slogic3d-cloud/heart/hardware/drc_report.txt

** Drc report for /home/user/heart-/hardware/heart.kicad_pcb **
** Created on 2026-10-11 21:35:21 **

** Found 1 DRC violations **
[lib_footprint_mismatch]: Footprint 'USB_C_Receptacle_HRO_TYPE-C-31-M-12' does not match copy in library 'Connector_USB'.
    Local override; Severity: warning
    @(104.8028 mm, 131.1972 mm): Footprint J1

** Found 0 unconnected pads **

** Found 0 Footprint errors **

** End of Report **
