slogic3d-cloud/heart/einkauf/price.md

# Preise – LED-Herz (Euro und Dollar)

Stand: **12.10.2026 18:22** · Kurs: 1 $ = 0,8926 € · 1 € = 1,1203 $ (open.er-api.com, Mon, 12 Oct 2026 00:02:32 +0000)

Neu berechnen: `python3 tools/einkauf.py --boards 2`. **Live** = gerade vom Shop abgefragt, **Schätzung** = bitte selbst prüfen.

## Zusammenfassung

| Posten | Euro | Dollar |
|---|---|---|
| JLCPCB: 5 Platinen, davon 2 bestückt, inkl. Versand | 71,56 € | 80,16 $ |
| Selbst kaufen (BerryBase + Amazon) | 40,56 € | 45,44 $ |
| **Gesamt** | **112,12 €** | **125,60 $** |

Versandkosten bei BerryBase und Amazon sind nicht eingerechnet (hängen vom Warenkorb ab).

## Selbst kaufen

| Teil | Shop | Menge | Stück € | Stück $ | Summe € | Summe $ | Preisquelle |
|---|---|---|---|---|---|---|---|
| Seeed Studio XIAO ESP32-C3 | Amazon | 1 | 6,85 € | 7,67 $ | 6,85 € | 7,67 $ | Referenz OpenELAB, live |
| Buchsenleiste 1x40, RM 2,54, gerade | BerryBase | 1 | 0,35 € | 0,39 $ | 0,35 € | 0,39 $ | BerryBase FEMH-1X40P, live |
| Kurzhubtaster 6x6 mm, THT, H 4,3 mm | BerryBase | 2 | 0,13 € | 0,15 $ | 0,26 € | 0,29 $ | BerryBase KHT66PV43, live |
| Elko 1000 µF / 25 V, Ø10 × 20 mm, RM 5 mm | BerryBase | 1 | 0,21 € | 0,24 $ | 0,21 € | 0,24 $ | BerryBase ELK1M25VAWH, live |
| Raspberry Pi USB-C-Netzteil 5,1 V / 3 A | BerryBase | 1 | 7,90 € | 8,85 $ | 7,90 € | 8,85 $ | BerryBase RPI4NT3AW, live |
| Anycubic PLA+ Filament, Rot, 1 kg, 1,75 mm | Amazon | 1 | 18,99 € | 21,27 $ | 18,99 € | 21,27 $ | Referenz Anycubic-Shop, live |
| Blechschrauben-Sortiment (2,9 × 9,5 mm) | Amazon | 1 | 6,00 € | 6,72 $ | 6,00 € | 6,72 $ | Richtwert (Schätzung) |
| **Summe** | | | | | **40,56 €** | **45,44 $** | |

## JLCPCB

| Posten | Dollar | Euro | Quelle |
|---|---|---|---|
| 5 × Leiterplatte 2 Lagen, 162 × 153 mm | 17,01 $ | 15,18 € | JLCPCB-Angebot 12.10.2026 (inkl. Ingenieurgebühr + Dateibestätigung) |
| 100nF 50V X7R 0603 (C14663) × 94 | 1,33 $ | 1,19 € | LCSC live, 0,0142 $/Stück |
| 10uF 25V X5R 0805 (C15850) × 2 | 0,14 $ | 0,12 € | LCSC live, 0,0695 $/Stück |
| 330R 1% 0603 (C23138) × 2 | 0,01 $ | 0,00 € | LCSC live, 0,0026 $/Stück |
| 5.1k 1% 0603 (C23186) × 4 | 0,01 $ | 0,01 € | LCSC live, 0,0015 $/Stück |
| SN74AHCT1G125DBVR (C7484) × 2 | 0,20 $ | 0,18 € | LCSC live, 0,1009 $/Stück |
| SS34 Schottky 40V 3A SMA (C408258) × 2 | 0,08 $ | 0,07 € | LCSC live, 0,0402 $/Stück |
| HRO TYPE-C-31-M-12 (C165948) × 2 | 0,38 $ | 0,34 € | LCSC live, 0,1879 $/Stück |
| WS2812B-B/W 5050 RGB LED (C114586) × 92 | 7,74 $ | 6,91 € | LCSC live, 0,0841 $/Stück |
| Bestückung: Einrichtung | 8,18 $ | 7,30 € | JLCPCB-Preisliste |
| Bestückung: Schablone | 1,53 $ | 1,37 € | JLCPCB-Preisliste |
| Bestückung: 618 Lötstellen | 0,99 $ | 0,88 € | JLCPCB-Preisliste |
| Bestückung: 4 Extended-Teile | 12,28 $ | 10,96 € | JLCPCB-Preisliste |
| Bestückung: ggf. Handlöten USB-C | 3,58 $ | 3,20 € | JLCPCB-Preisliste |
| Versand nach Deutschland | 26,72 $ | 23,85 € | JLCPCB-Angebot, DHL Express (billigere Versandart wählbar) |
| **Summe JLCPCB** | **80,16 $** | **71,56 €** | |

Platinenfläche ca. 247 cm², also kein Großformat-Aufschlag (erst ab 650 cm²). Leiterplatte und Versand: echtes JLCPCB-Angebot. Bauteile und Bestückung: berechnet aus LCSC-Preisen und der JLCPCB-Preisliste – den genauen Betrag zeigt JLCPCB, sobald die Leiterplattenmontage eingeschaltet ist. Gutscheine von JLCPCB sind nicht abgezogen.

## Filament (Anycubic Kobra 2 Neo)

| Teil | Gramm |
|---|---|
| Rückschale | 89 g |
| Pixel-Gitter | 58 g |
| Diffusor | 22 g |
| Ständer | 41 g |
| Tasterstößel | 1 g |
| **Summe** | **210 g** → 1 Rolle à 1 kg reicht |
