slogic3d-cloud/heart/hardware/production/heart_bom.csv

Comment | Designator | Footprint | LCSC Part #
100nF 50V X7R 0603 | C1,C2,C3,C4,C5,C6,C7,C8,C9,C10,C11,C12,C13,C14,C15,C16,C17,C18,C19,C20,C21,C22,C23,C24,C25,C26,C27,C28,C29,C30,C31,C32,C33,C34,C35,C36,C37,C38,C39,C40,C41,C42,C43,C44,C45,C46,C48 | C_0603_1608Metric | C14663
10uF 25V X5R 0805 | C49 | C_0805_2012Metric | C15850
330R 1% 0603 | R1 | R_0603_1608Metric | C23138
5.1k 1% 0603 | R2,R3 | R_0603_1608Metric | C23186
SN74AHCT1G125DBVR | U1 | SOT-23-5 | C7484
SS34 Schottky 40V 3A SMA | D47 | D_SMA | C408258
HRO TYPE-C-31-M-12 | J1 | USB_C_Receptacle_HRO_TYPE-C-31-M-12 | C165948
WS2812B-B/W 5050 RGB LED | D1,D2,D3,D4,D5,D6,D7,D8,D9,D10,D11,D12,D13,D14,D15,D16,D17,D18,D19,D20,D21,D22,D23,D24,D25,D26,D27,D28,D29,D30,D31,D32,D33,D34,D35,D36,D37,D38,D39,D40,D41,D42,D43,D44,D45,D46 | LED_WS2812B_PLCC4_5.0x5.0mm_P3.2mm | C114586
