slogic3d-cloud/heart/hardware/chain_order.txt

# index col row  (Reihenfolge der Datenleitung)
0 4 7
1 5 6
2 4 6
3 3 6
4 2 5
5 3 5
6 4 5
7 5 5
8 6 5
9 7 4
10 6 4
11 5 4
12 4 4
13 3 4
14 2 4
15 1 4
16 0 3
17 1 3
18 2 3
19 3 3
20 4 3
21 5 3
22 6 3
23 7 3
24 8 3
25 8 2
26 7 2
27 6 2
28 5 2
29 4 2
30 3 2
31 2 2
32 1 2
33 0 2
34 0 1
35 1 1
36 2 1
37 3 1
38 5 1
39 6 1
40 7 1
41 8 1
42 7 0
43 6 0
44 2 0
45 1 0
