slogic3d-cloud/heart/cad/out/heart_case_assembly.step

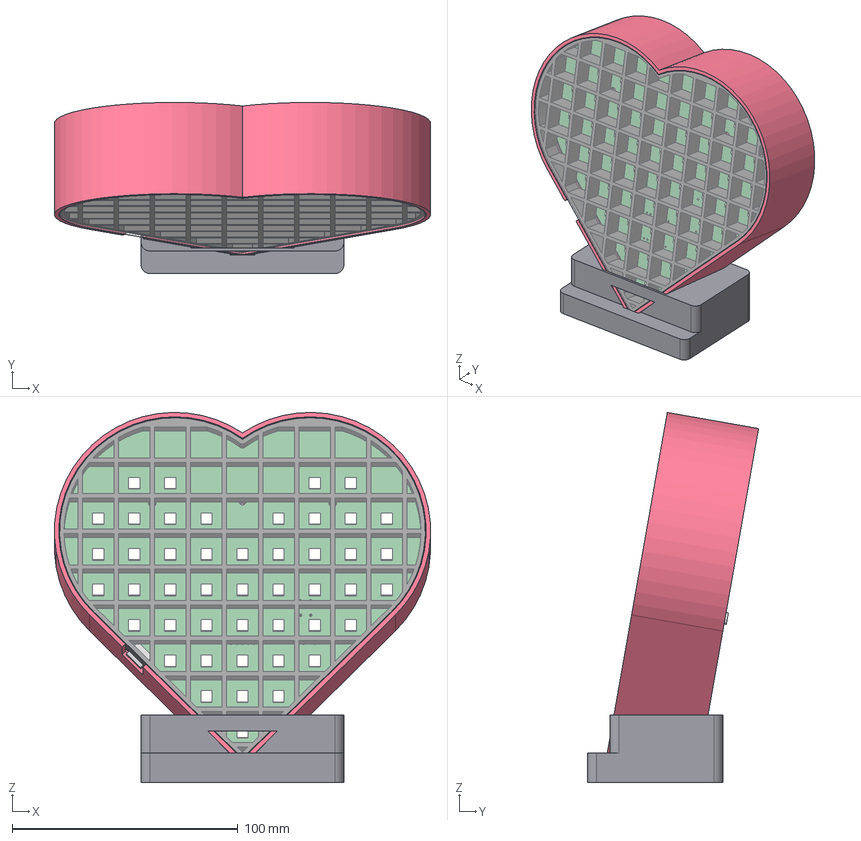
[picture p9: CAD file, 2026-10-12]
cad/out/heart_case_assembly.step
166.7 x 75.9 x 164.1 mm
heart_case_shell
heart_case_grid
heart_case_diffuser
heart_case_button_plunger
heart_stand
platzhalter_pcb
platzhalter_xiao
platzhalter_elko
platzhalter_button
platzhalter_usb
platzhalter_leds
