slogic3d-cloud/heart/cad/out/heart_case_shell.step

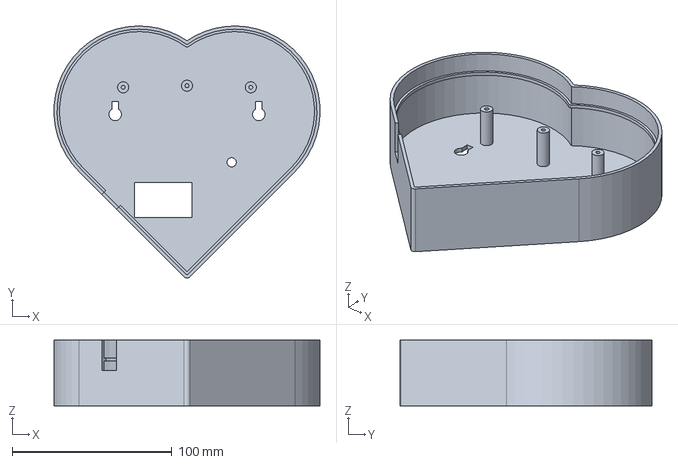
[picture p10: CAD file, 2026-10-12]
cad/out/heart_case_shell.step
166.7 x 157.9 x 41.1 mm
