slogic3d-cloud/heart/cad/out/heart_case_button_plunger.step

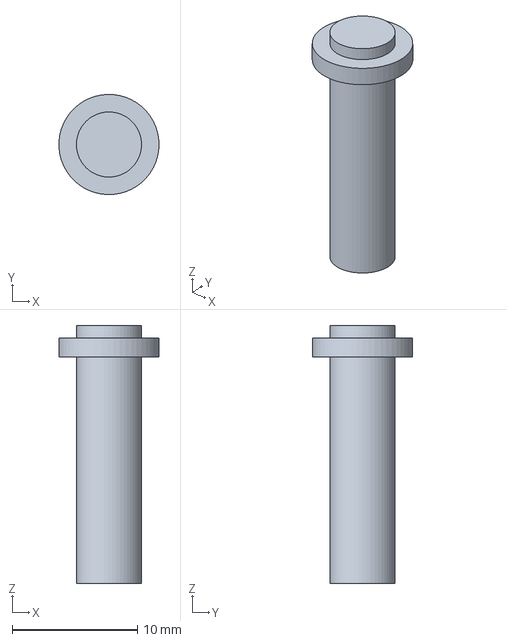
[picture p11: CAD file, 2026-10-12]
cad/out/heart_case_button_plunger.step
7.99 x 8.00 x 20.6 mm
