slogic3d-cloud/heart/cad/out/heart_case_grid.step

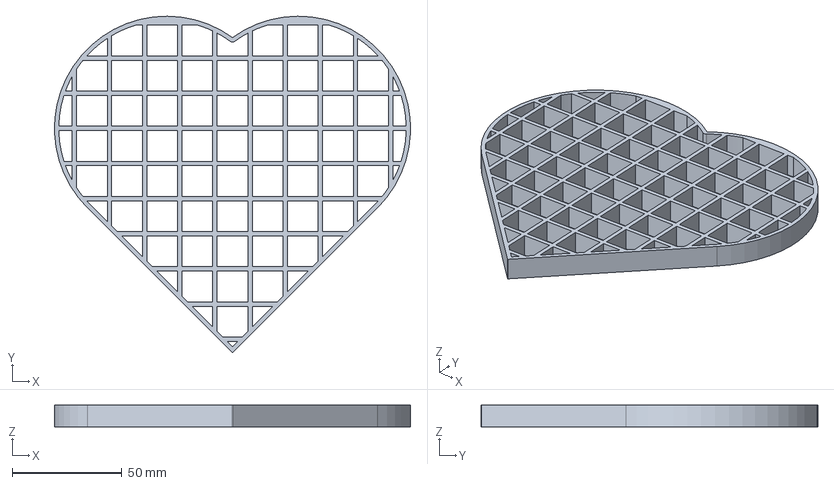
[picture p12: CAD file, 2026-10-12]
cad/out/heart_case_grid.step
162.1 x 153.3 x 10.0 mm
