slogic3d-cloud/heart/cad/out/heart_stand.step

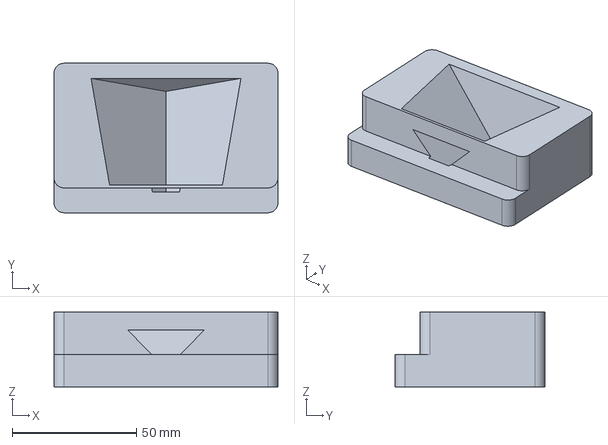
[picture p13: CAD file, 2026-10-12]
cad/out/heart_stand.step
90.0 x 60.1 x 30.0 mm
