slogic3d-cloud/heart/cad/out/heart_case_diffuser.step

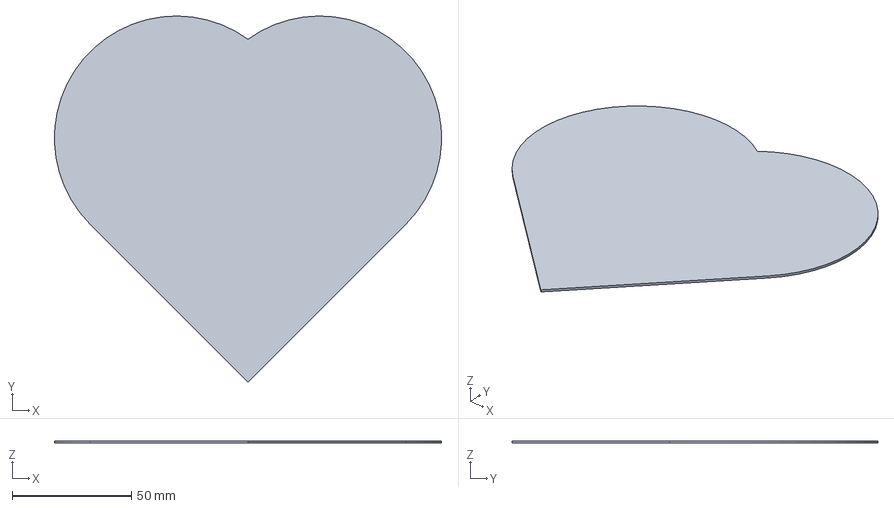
[picture p14: CAD file, 2026-10-12]
cad/out/heart_case_diffuser.step
162.1 x 153.3 x 1.00 mm
