slogic3d-cloud/heart/cad/out/heart_pcb.step

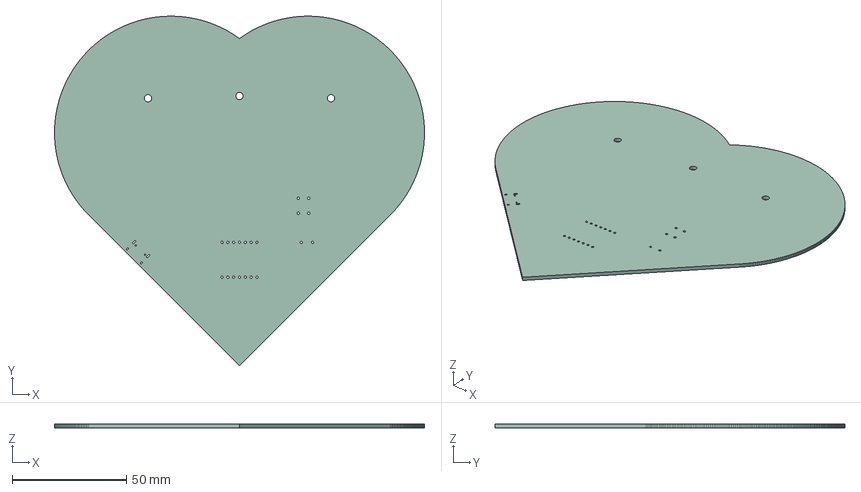
[picture p15: CAD file, 2026-10-12]
cad/out/heart_pcb.step
161.8 x 152.9 x 1.60 mm
