slogic3d-cloud/heart/(list of files, cad)

Other CAD files:
cad/out/heart_case_button_plunger.3mf
cad/out/heart_case_button_plunger.stl
cad/out/heart_case_diffuser.3mf
cad/out/heart_case_diffuser.stl
cad/out/heart_case_grid.3mf
cad/out/heart_case_grid.stl
cad/out/heart_case_shell.3mf
cad/out/heart_case_shell.stl
cad/out/heart_stand.3mf
cad/out/heart_stand.stl
