slogic3d-cloud/heart/docs/schematic.pdf

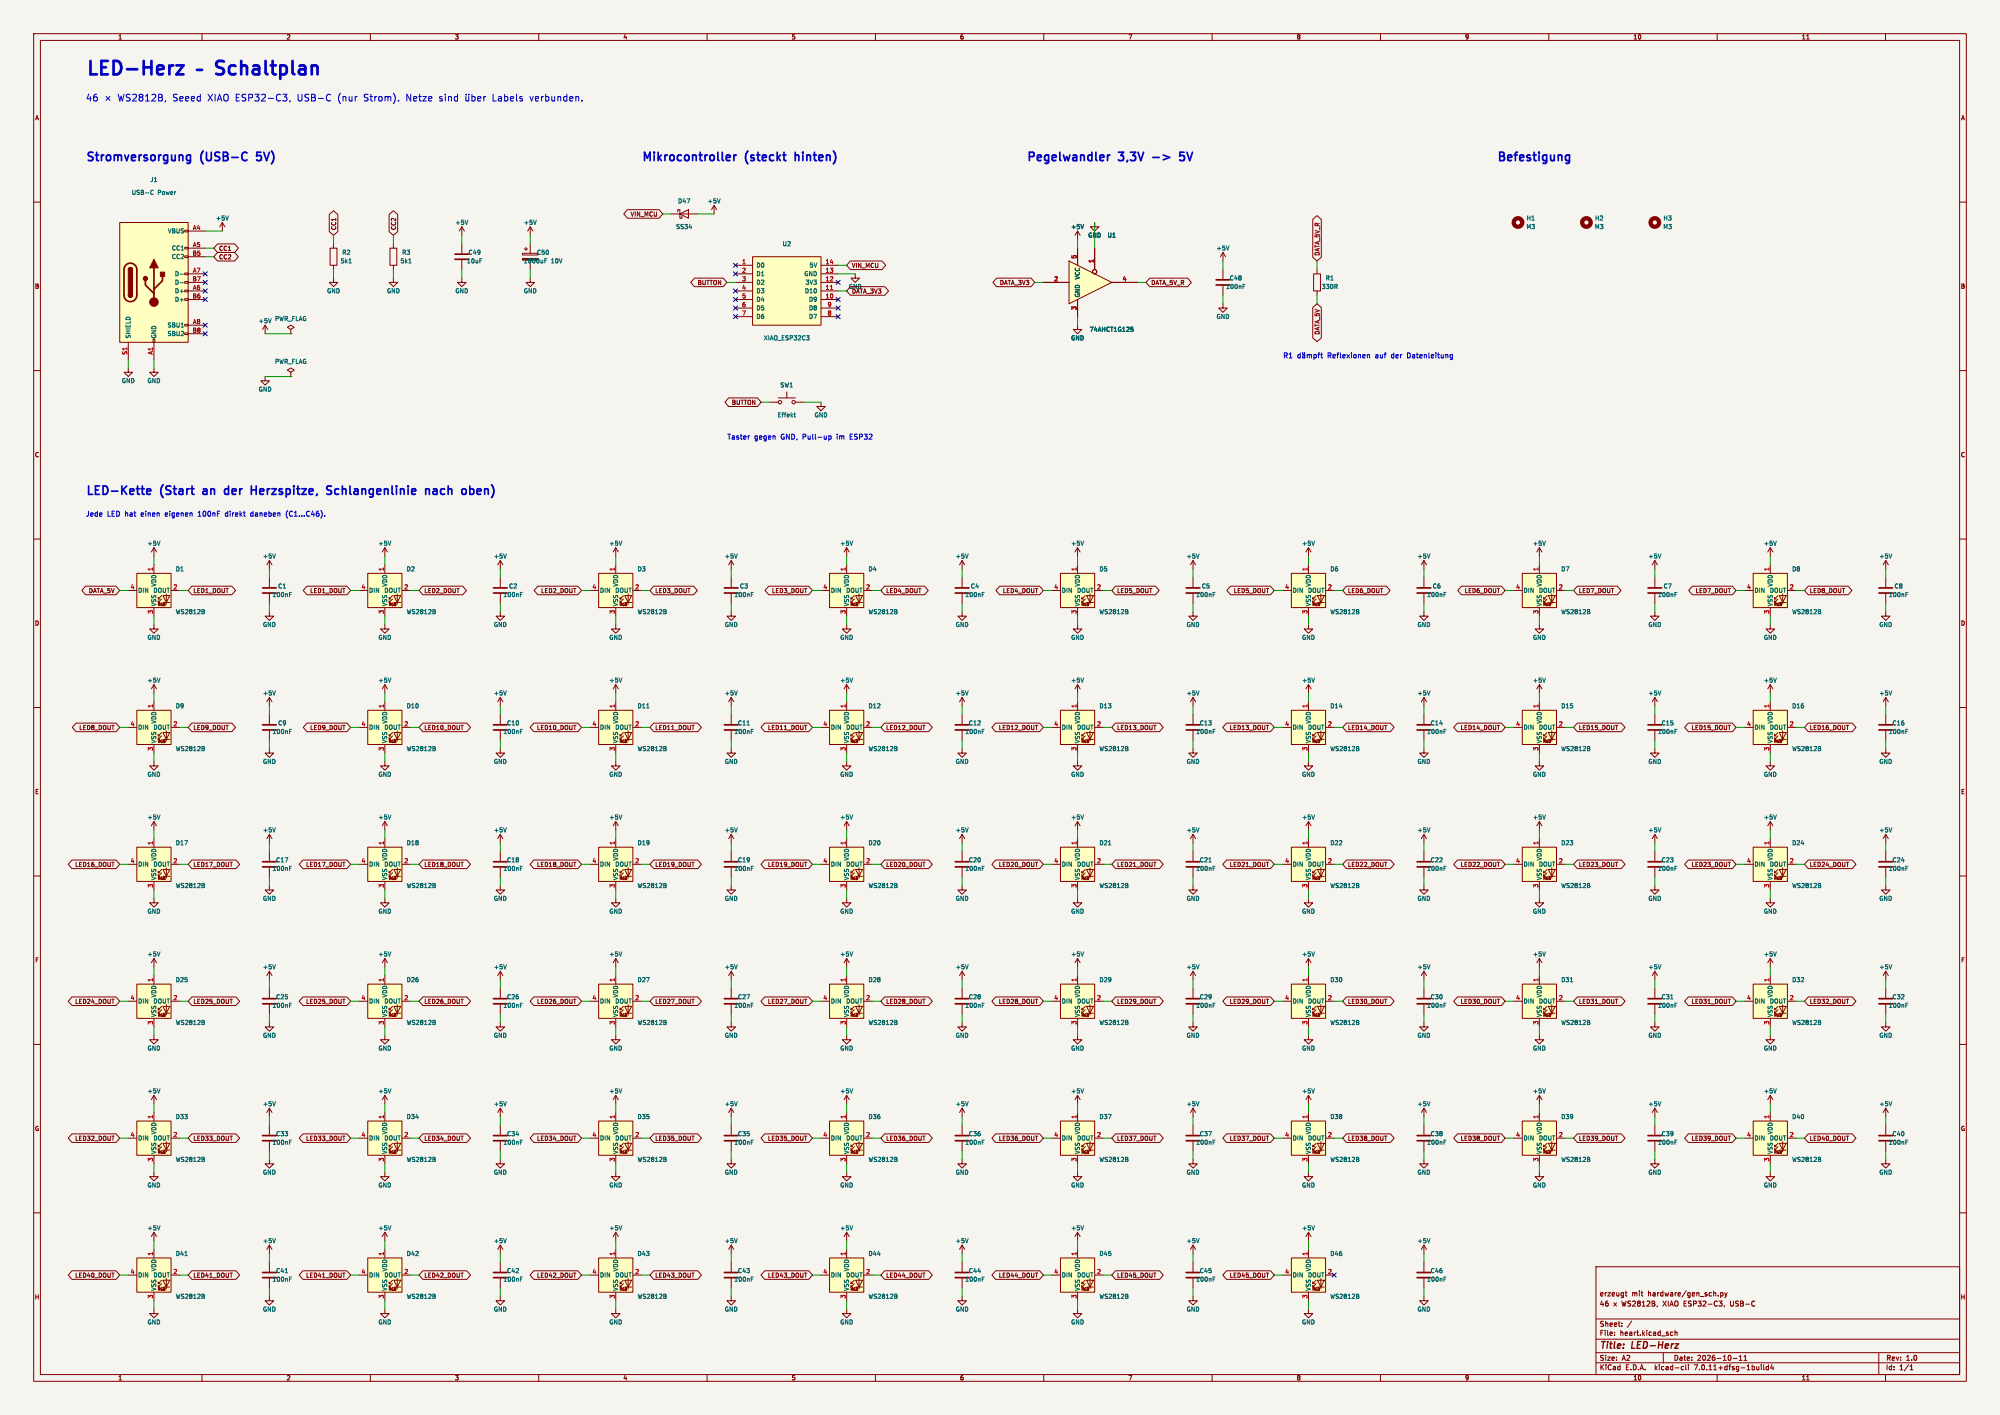
[picture p18: page 1]
