slogic3d-cloud/heart/hardware/heart.kicad_pcb

## KiCad design hardware/heart.kicad_pcb (2026-10-11)

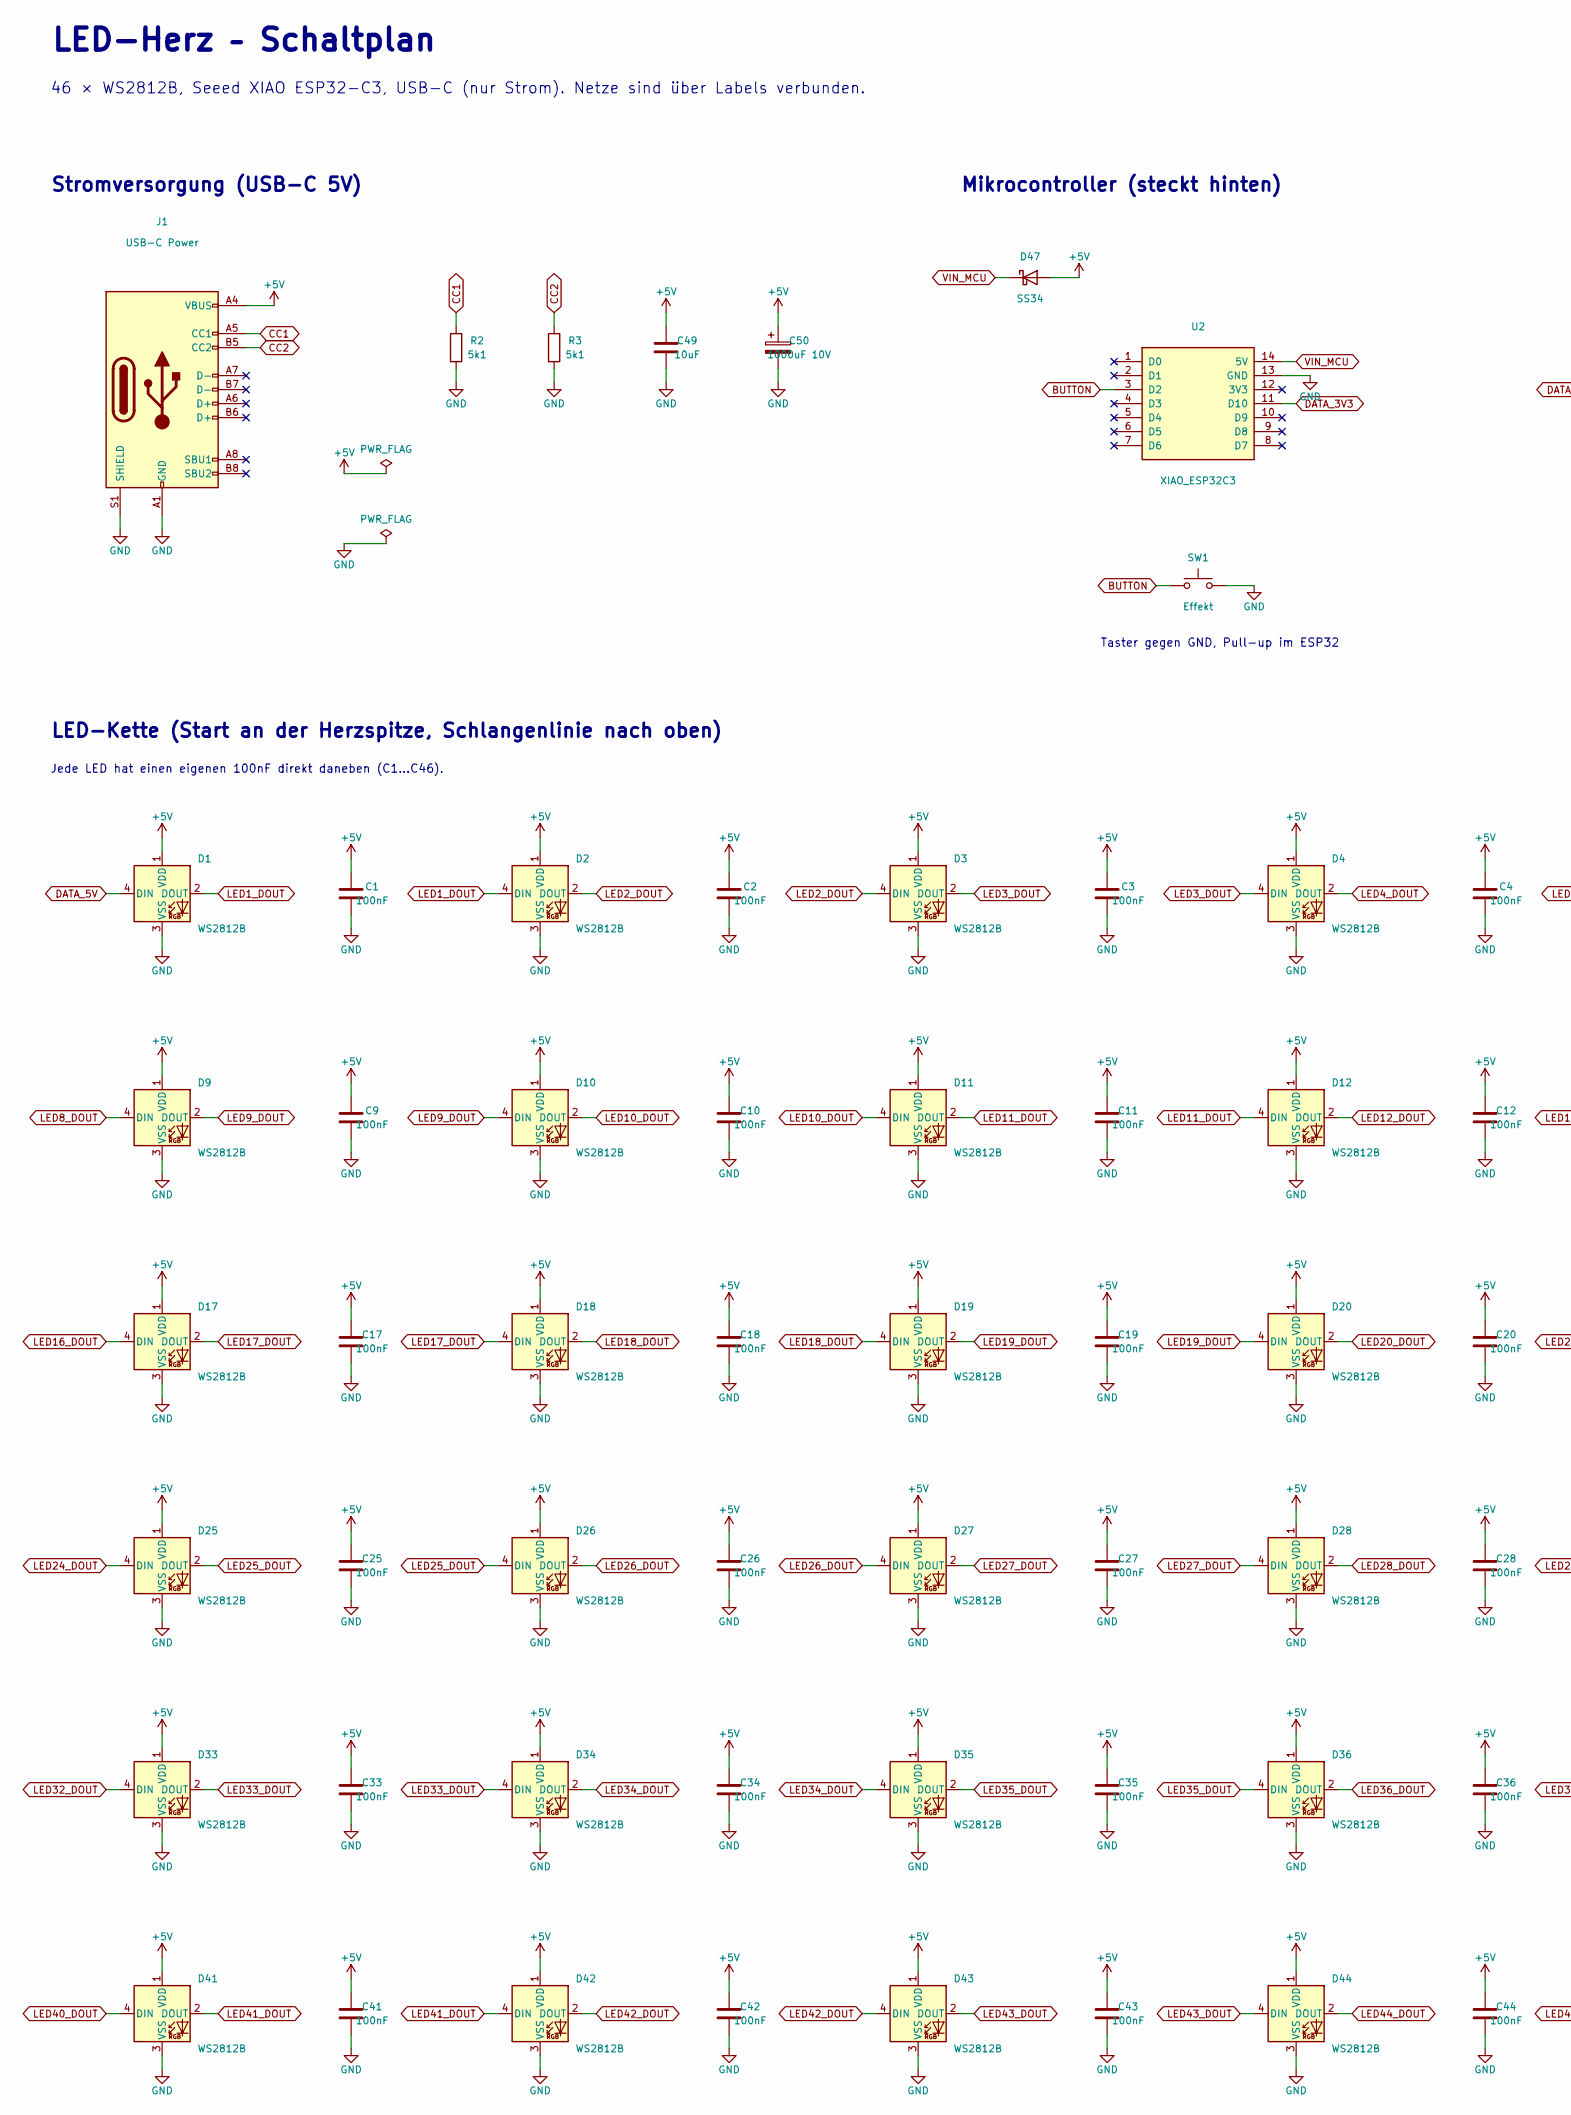
[picture p19: schematic heart.kicad_sch, LED-Herz, part in row 1, column 1]

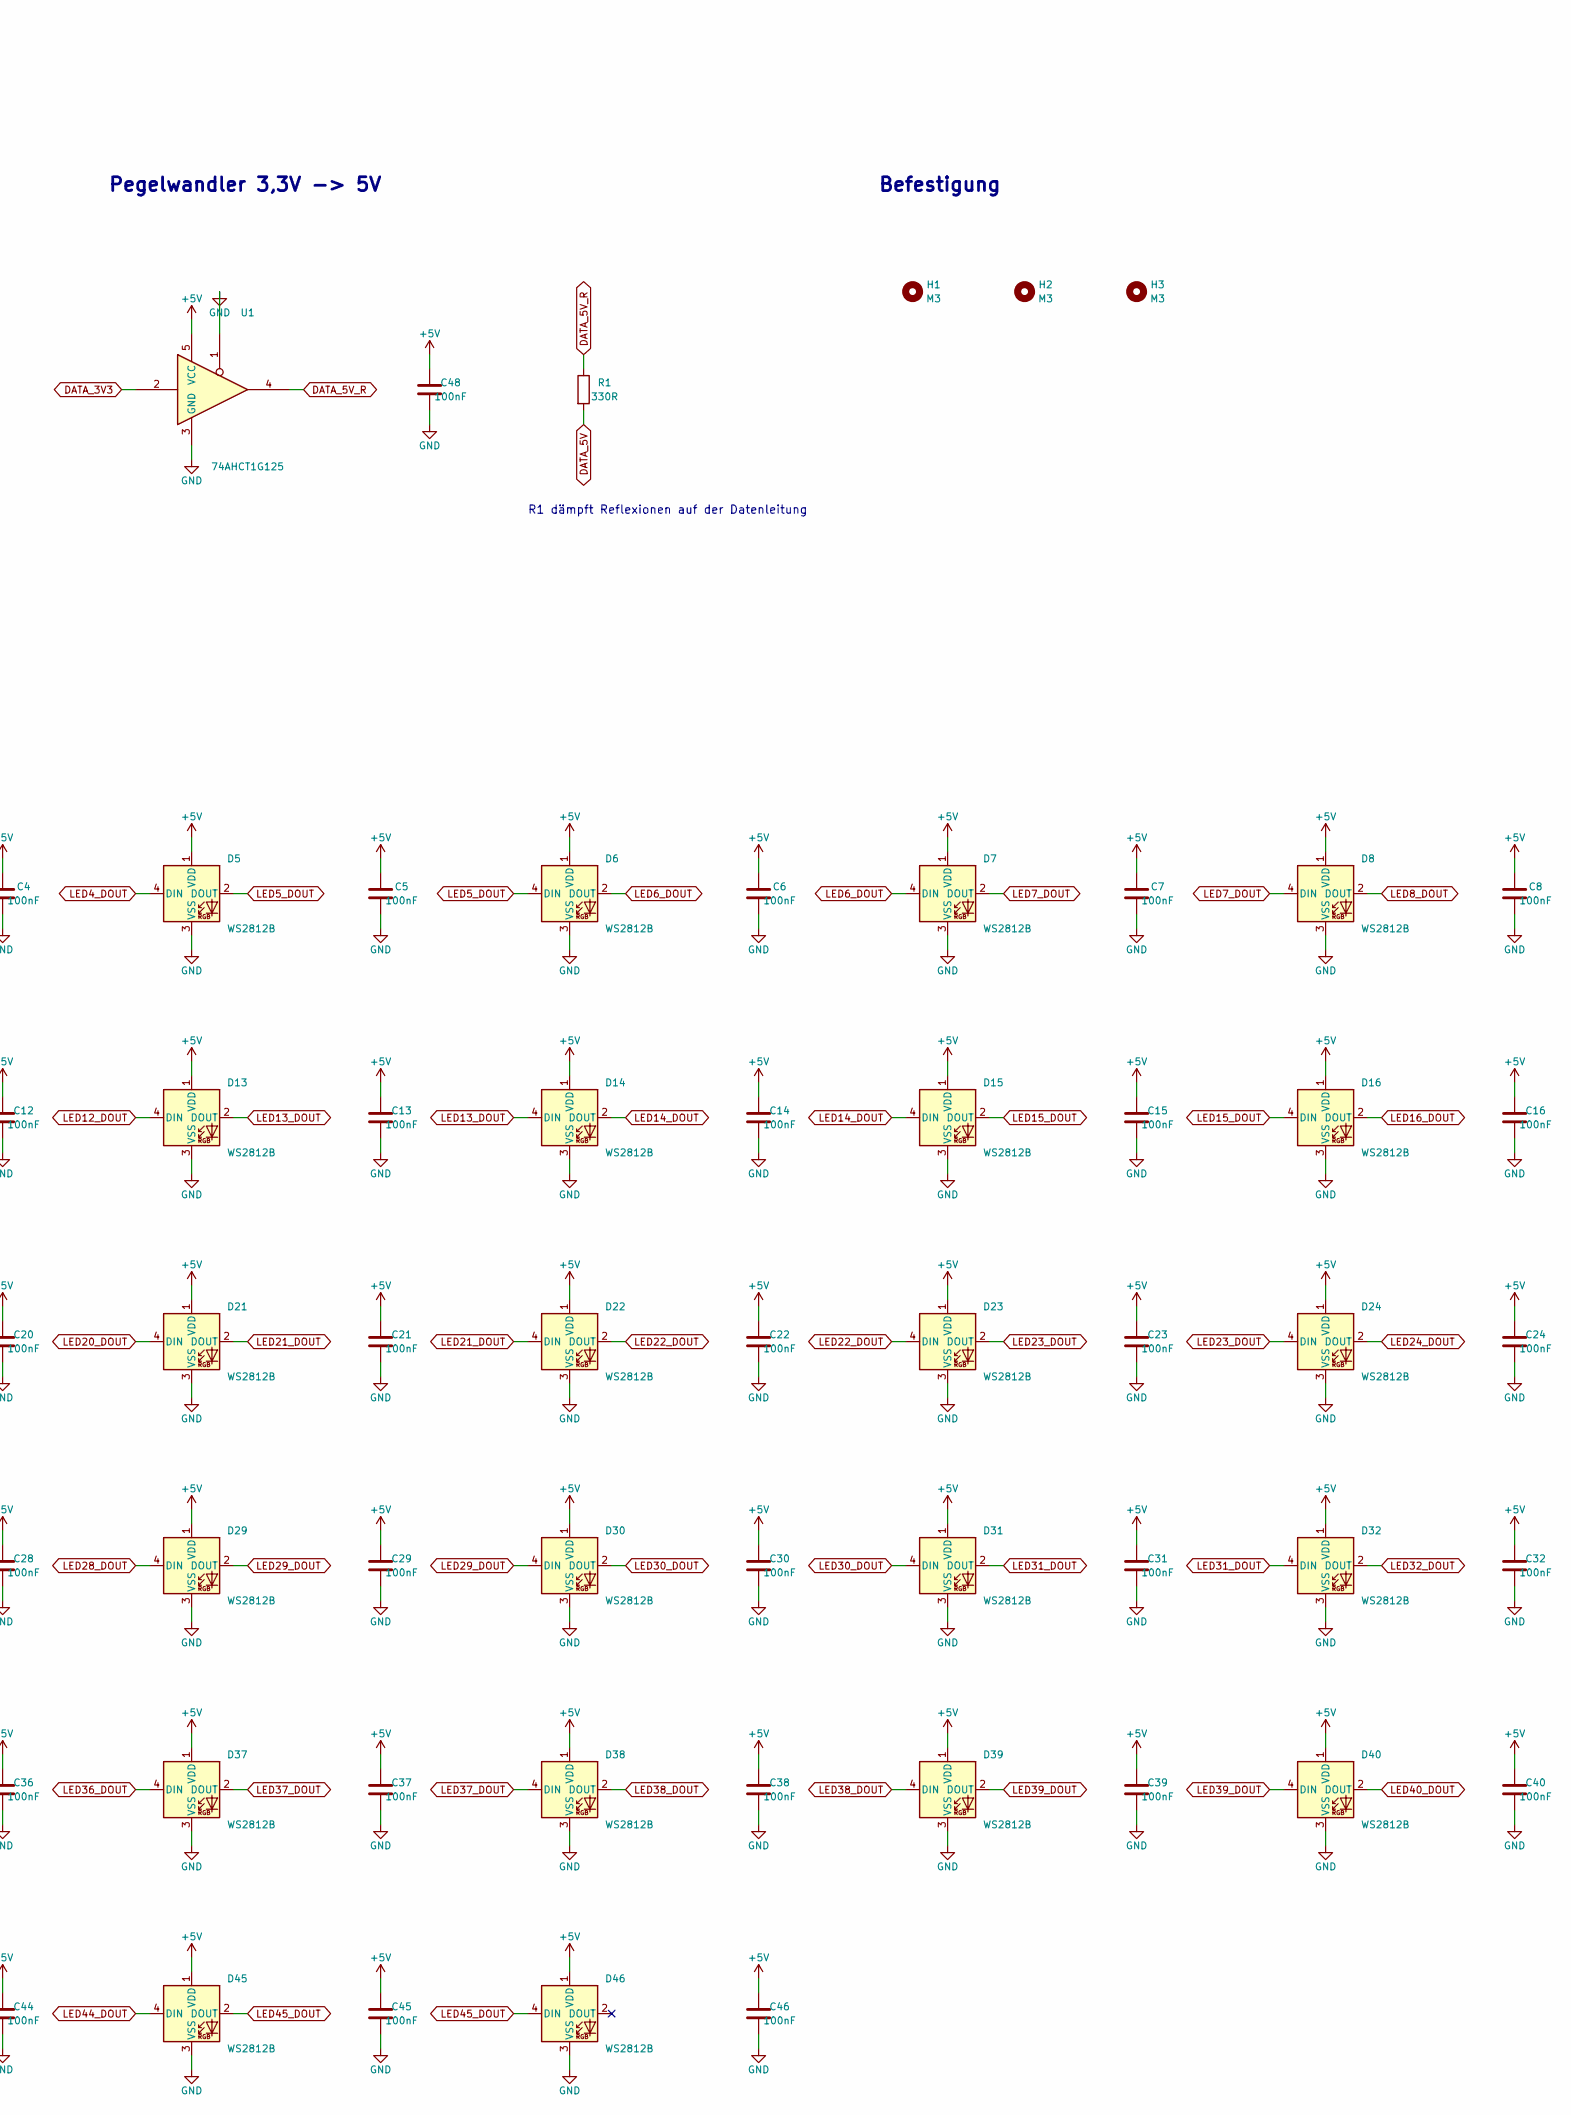
[picture p20: schematic heart.kicad_sch, LED-Herz, part in row 1, column 2]

Parts:
C1, C2, C3, C4, C5, C6, C7, C8, C9, C10, C11, C12, C13, C14, C15, C16, C17, C18, C19, C20, C21, C22, C23, C24, C25, C26, C27, C28, C29, C30, C31, C32, C33, C34, C35, C36, C37, C38, C39, C40, C41, C42, C43, C44, C45, C46, C48: 100nF; C_0603_1608Metric; LCSC C14663
C49: 10uF; C_0805_2012Metric; LCSC C15850
C50: 1000uF 10V; CP_Radial_D10.0mm_P5.00mm
D1, D2, D3, D4, D5, D6, D7, D8, D9, D10, D11, D12, D13, D14, D15, D16, D17, D18, D19, D20, D21, D22, D23, D24, D25, D26, D27, D28, D29, D30, D31, D32, D33, D34, D35, D36, D37, D38, D39, D40, D41, D42, D43, D44, D45, D46: WS2812B; LED_WS2812B_PLCC4_5.0x5.0mm_P3.2mm; LCSC C114586
D47: SS34; D_SMA; LCSC C408258
H1, H2, H3: M3; MountingHole_3.2mm_M3
J1: USB-C Power; USB_C_Receptacle_HRO_TYPE-C-31-M-12; LCSC C165948
R1: 330R; R_0603_1608Metric; LCSC C23138
R2, R3: 5k1; R_0603_1608Metric; LCSC C23186
SW1: Effekt; SW_PUSH_6mm
U1: 74AHCT1G125; SOT-23-5; LCSC C7484
U2: XIAO_ESP32C3; Seeed_XIAO_Socket

Connections:
+5V: C1.1, C2.1, C3.1, C4.1, C5.1, C6.1, C7.1, C8.1, C9.1, C10.1, C11.1, C12.1, C13.1, C14.1, C15.1, C16.1, C17.1, C18.1, C19.1, C20.1, C21.1, C22.1, C23.1, C24.1, C25.1, C26.1, C27.1, C28.1, C29.1, C30.1, C31.1, C32.1, C33.1, C34.1, C35.1, C36.1, C37.1, C38.1, C39.1, C40.1, C41.1, C42.1, C43.1, C44.1, C45.1, C46.1, C48.1, C49.1, C50.1, D1.1 (VDD), D2.1 (VDD), D3.1 (VDD), D4.1 (VDD), D5.1 (VDD), D6.1 (VDD), D7.1 (VDD), D8.1 (VDD), D9.1 (VDD), D10.1 (VDD), D11.1 (VDD), D12.1 (VDD), D13.1 (VDD), D14.1 (VDD), D15.1 (VDD), D16.1 (VDD), D17.1 (VDD), D18.1 (VDD), D19.1 (VDD), D20.1 (VDD), D21.1 (VDD), D22.1 (VDD), D23.1 (VDD), D24.1 (VDD), D25.1 (VDD), D26.1 (VDD), D27.1 (VDD), D28.1 (VDD), D29.1 (VDD), D30.1 (VDD), D31.1 (VDD), D32.1 (VDD), D33.1 (VDD), D34.1 (VDD), D35.1 (VDD), D36.1 (VDD), D37.1 (VDD), D38.1 (VDD), D39.1 (VDD), D40.1 (VDD), D41.1 (VDD), D42.1 (VDD), D43.1 (VDD), D44.1 (VDD), D45.1 (VDD), D46.1 (VDD), D47.2 (A), J1.A4 (VBUS), J1.A9 (VBUS), J1.B4 (VBUS), J1.B9 (VBUS), U1.5 (VCC)
BUTTON: SW1.1, U2.3 (D2)
CC1: J1.A5 (CC1), R2.1
CC2: J1.B5 (CC2), R3.1
DATA_3V3: U1.2, U2.11 (D10)
DATA_5V: D1.4 (DIN), R1.2
DATA_5V_R: R1.1, U1.4
GND: C1.2, C2.2, C3.2, C4.2, C5.2, C6.2, C7.2, C8.2, C9.2, C10.2, C11.2, C12.2, C13.2, C14.2, C15.2, C16.2, C17.2, C18.2, C19.2, C20.2, C21.2, C22.2, C23.2, C24.2, C25.2, C26.2, C27.2, C28.2, C29.2, C30.2, C31.2, C32.2, C33.2, C34.2, C35.2, C36.2, C37.2, C38.2, C39.2, C40.2, C41.2, C42.2, C43.2, C44.2, C45.2, C46.2, C48.2, C49.2, C50.2, D1.3 (VSS), D2.3 (VSS), D3.3 (VSS), D4.3 (VSS), D5.3 (VSS), D6.3 (VSS), D7.3 (VSS), D8.3 (VSS), D9.3 (VSS), D10.3 (VSS), D11.3 (VSS), D12.3 (VSS), D13.3 (VSS), D14.3 (VSS), D15.3 (VSS), D16.3 (VSS), D17.3 (VSS), D18.3 (VSS), D19.3 (VSS), D20.3 (VSS), D21.3 (VSS), D22.3 (VSS), D23.3 (VSS), D24.3 (VSS), D25.3 (VSS), D26.3 (VSS), D27.3 (VSS), D28.3 (VSS), D29.3 (VSS), D30.3 (VSS), D31.3 (VSS), D32.3 (VSS), D33.3 (VSS), D34.3 (VSS), D35.3 (VSS), D36.3 (VSS), D37.3 (VSS), D38.3 (VSS), D39.3 (VSS), D40.3 (VSS), D41.3 (VSS), D42.3 (VSS), D43.3 (VSS), D44.3 (VSS), D45.3 (VSS), D46.3 (VSS), J1.A1 (GND), J1.A12 (GND), J1.B1 (GND), J1.B12 (GND), J1.S1 (SHIELD), R2.2, R3.2, SW1.2, U1.1, U1.3 (GND), U2.13 (GND)
LED1_DOUT: D1.2 (DOUT), D2.4 (DIN)
LED2_DOUT: D2.2 (DOUT), D3.4 (DIN)
LED3_DOUT: D3.2 (DOUT), D4.4 (DIN)
LED4_DOUT: D4.2 (DOUT), D5.4 (DIN)
LED5_DOUT: D5.2 (DOUT), D6.4 (DIN)
LED6_DOUT: D6.2 (DOUT), D7.4 (DIN)
LED7_DOUT: D7.2 (DOUT), D8.4 (DIN)
LED8_DOUT: D8.2 (DOUT), D9.4 (DIN)
LED9_DOUT: D9.2 (DOUT), D10.4 (DIN)
LED10_DOUT: D10.2 (DOUT), D11.4 (DIN)
LED11_DOUT: D11.2 (DOUT), D12.4 (DIN)
LED12_DOUT: D12.2 (DOUT), D13.4 (DIN)
LED13_DOUT: D13.2 (DOUT), D14.4 (DIN)
LED14_DOUT: D14.2 (DOUT), D15.4 (DIN)
LED15_DOUT: D15.2 (DOUT), D16.4 (DIN)
LED16_DOUT: D16.2 (DOUT), D17.4 (DIN)
LED17_DOUT: D17.2 (DOUT), D18.4 (DIN)
LED18_DOUT: D18.2 (DOUT), D19.4 (DIN)
LED19_DOUT: D19.2 (DOUT), D20.4 (DIN)
LED20_DOUT: D20.2 (DOUT), D21.4 (DIN)
LED21_DOUT: D21.2 (DOUT), D22.4 (DIN)
LED22_DOUT: D22.2 (DOUT), D23.4 (DIN)
LED23_DOUT: D23.2 (DOUT), D24.4 (DIN)
LED24_DOUT: D24.2 (DOUT), D25.4 (DIN)
LED25_DOUT: D25.2 (DOUT), D26.4 (DIN)
LED26_DOUT: D26.2 (DOUT), D27.4 (DIN)
LED27_DOUT: D27.2 (DOUT), D28.4 (DIN)
LED28_DOUT: D28.2 (DOUT), D29.4 (DIN)
LED29_DOUT: D29.2 (DOUT), D30.4 (DIN)
LED30_DOUT: D30.2 (DOUT), D31.4 (DIN)
LED31_DOUT: D31.2 (DOUT), D32.4 (DIN)
LED32_DOUT: D32.2 (DOUT), D33.4 (DIN)
LED33_DOUT: D33.2 (DOUT), D34.4 (DIN)
LED34_DOUT: D34.2 (DOUT), D35.4 (DIN)
LED35_DOUT: D35.2 (DOUT), D36.4 (DIN)
LED36_DOUT: D36.2 (DOUT), D37.4 (DIN)
LED37_DOUT: D37.2 (DOUT), D38.4 (DIN)
LED38_DOUT: D38.2 (DOUT), D39.4 (DIN)
LED39_DOUT: D39.2 (DOUT), D40.4 (DIN)
LED40_DOUT: D40.2 (DOUT), D41.4 (DIN)
LED41_DOUT: D41.2 (DOUT), D42.4 (DIN)
LED42_DOUT: D42.2 (DOUT), D43.4 (DIN)
LED43_DOUT: D43.2 (DOUT), D44.4 (DIN)
LED44_DOUT: D44.2 (DOUT), D45.4 (DIN)
LED45_DOUT: D45.2 (DOUT), D46.4 (DIN)
VIN_MCU: D47.1 (K), U2.14 (5V)

Notes on the sheet:
LED-Herz – Schaltplan
46 × WS2812B, Seeed XIAO ESP32-C3, USB-C (nur Strom). Netze sind über Labels verbunden.
Stromversorgung (USB-C 5V)
Mikrocontroller (steckt hinten)
Taster gegen GND, Pull-up im ESP32
Pegelwandler 3,3V -> 5V
R1 dämpft Reflexionen auf der Datenleitung
Befestigung
LED-Kette (Start an der Herzspitze, Schlangenlinie nach oben)
Jede LED hat einen eigenen 100nF direkt daneben (C1…C46).

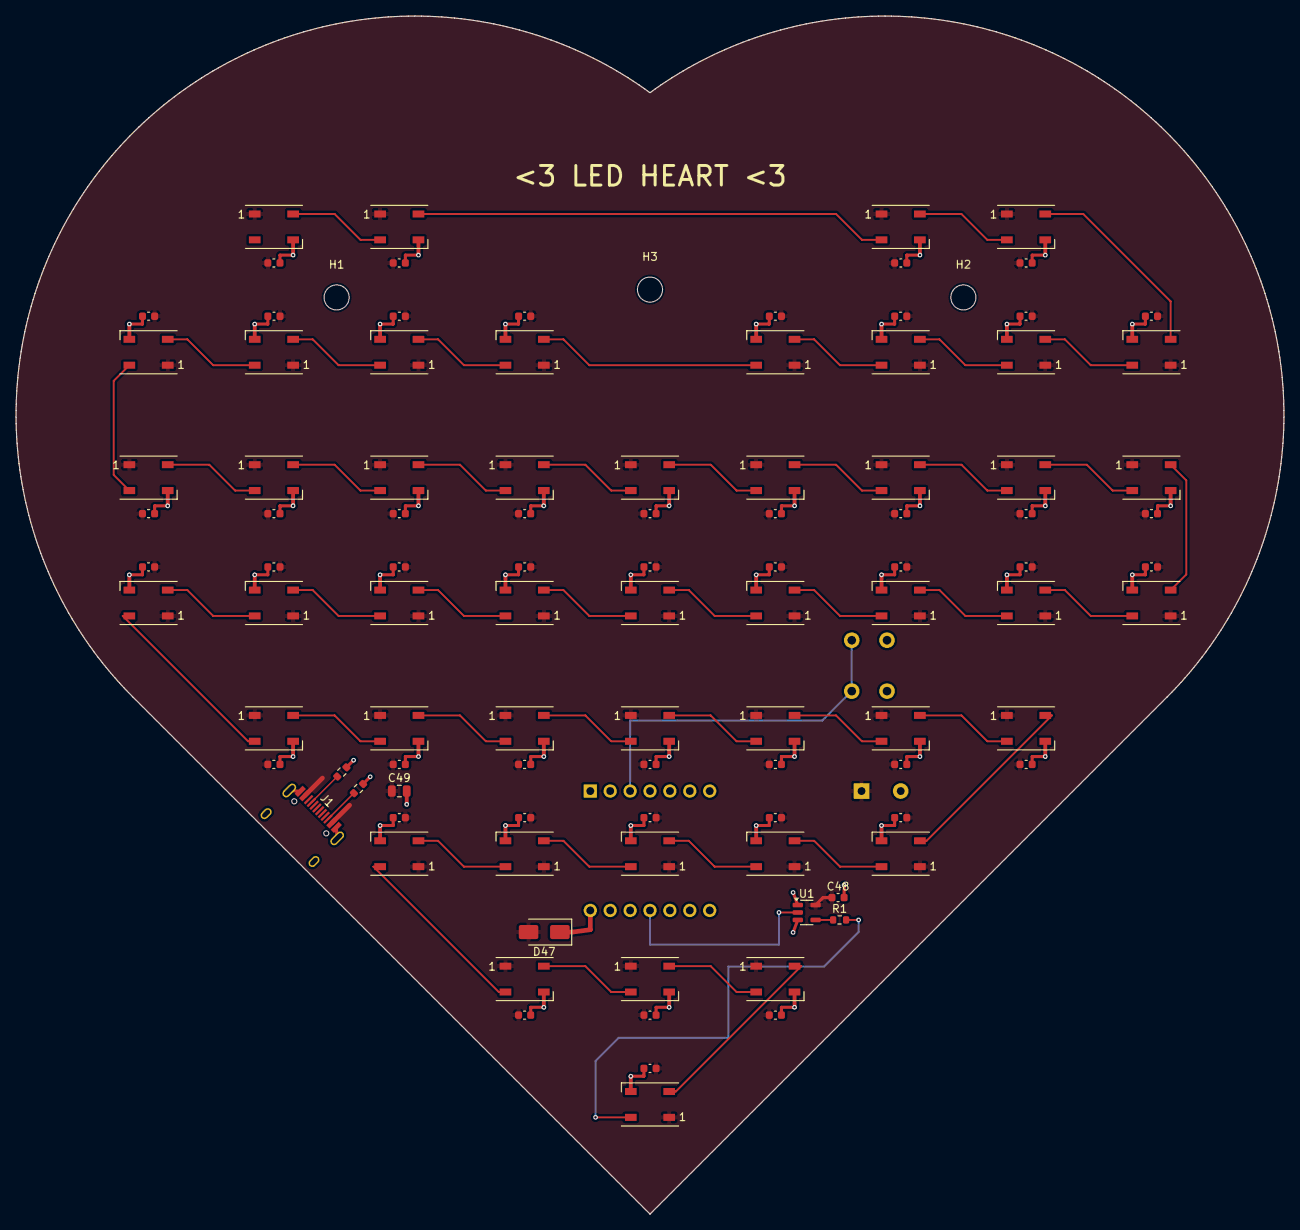
[picture p21: board heart.kicad_pcb from above]

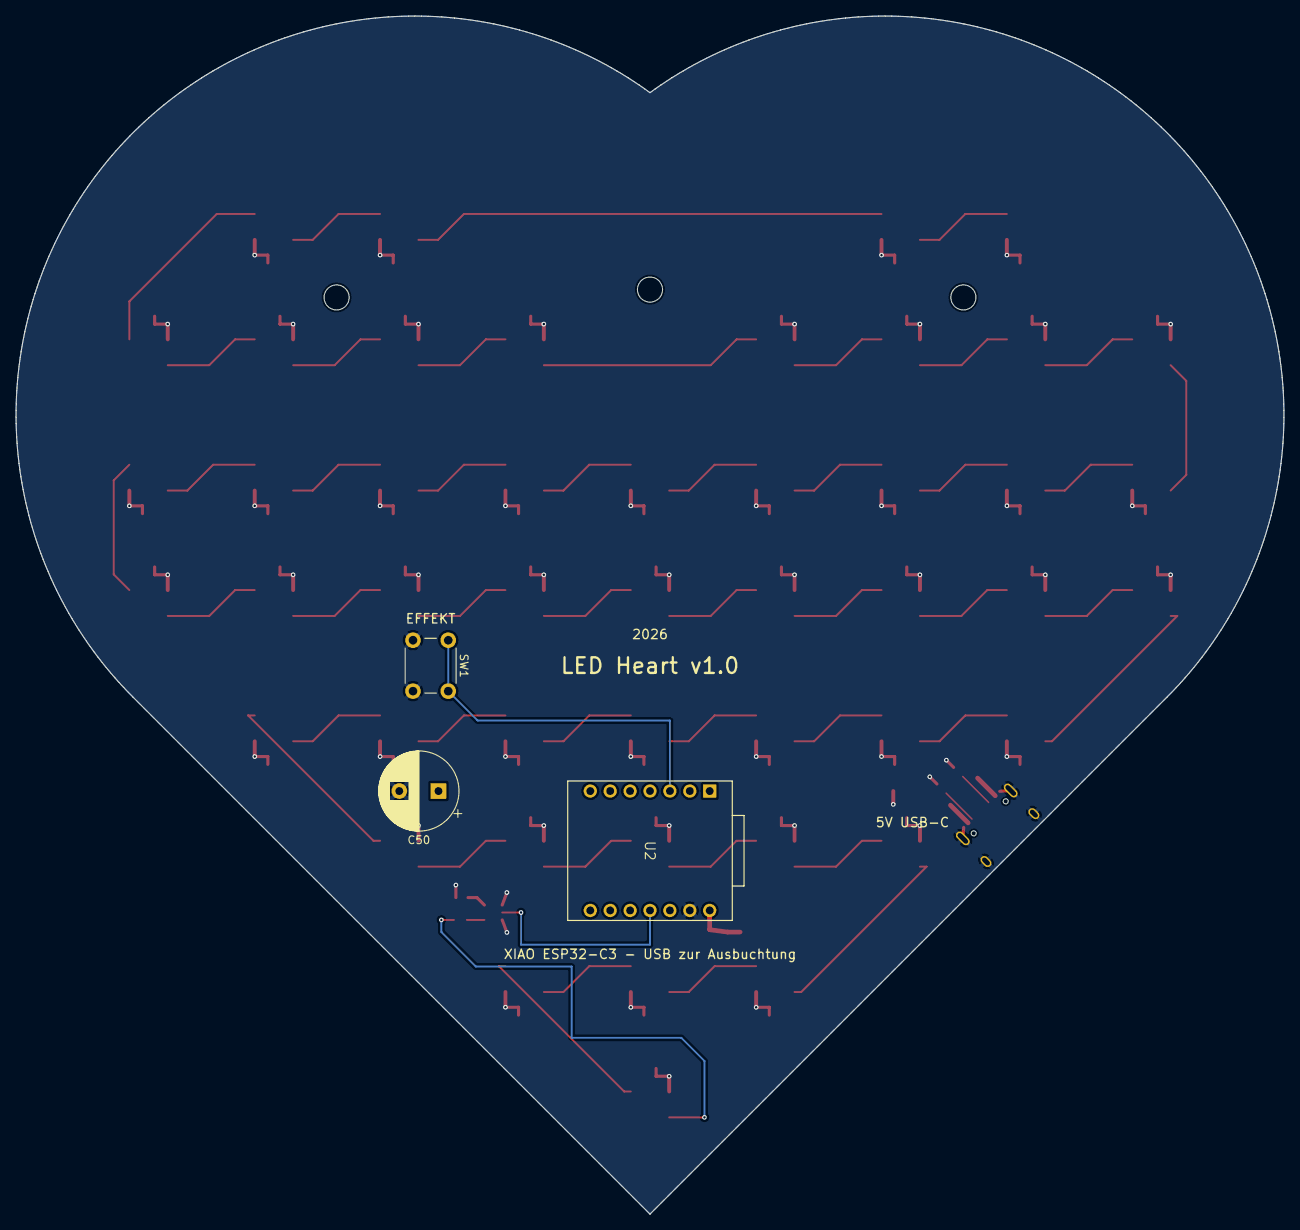
[picture p22: board heart.kicad_pcb from below]

Board: 2 copper layers, 161.8 x 152.9 mm, 106 parts (3 on the bottom side), 54 nets.
