slogic3d-cloud/heart/(commit log)

2026-10-11 LED-Herz: herzförmige Platine, Firmware, Doku
    - hardware/gen_pcb.py erzeugt die KiCad-Platine per Skript: Herzumriss
    (zwei Bögen + 45°-Flanken), 46 WS2812B mit je 100 nF, Datenkette,
    USB-C (nur Strom), 74AHCT1G125-Pegelwandler, XIAO ESP32-C3 hinten,
    Taster, +5V-Fläche oben / GND-Fläche unten
    - DRC: 0 Fehler, 0 offene Verbindungen (hardware/drc.py)
    - hardware/export.py baut Gerber, BOM und CPL für JLCPCB (LCSC geprüft)
    - Firmware (PlatformIO, FastLED): 7 Effekte + Auto, Taster kurz/lang,
    Einstellungen bleiben gespeichert
    - test/test_chain.cpp prüft LED-Reihenfolge Firmware vs. Platine
    - tools/preview.html: Effekte im Browser ansehen
    - README.md, JOURNAL.md, Schaltplan und Plat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
    [heart.kicad_pcb, heart_bom.csv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]
2026-10-11 KiCad-Schaltplan hinzugefügt und mit der Platine verknüpft
    - hardware/gen_sch.py erzeugt hardware/heart.kicad_sch (A2) mit den
    KiCad-Standardsymbolen plus eigenem XIAO-Symbol (heart.kicad_sym)
    - hardware/netlist.py: gemeinsame Bauteil-/Netzliste, feste UUIDs
    - gen_pcb.py setzt dieselben UUIDs in die Footprints, damit
    "Leiterplatte aus Schaltplan aktualisieren" funktioniert
    - hardware/check_sch.py vergleicht die KiCad-Netzliste Pin für Pin mit
    der Platine (106 Bauteile, 54 Netze, 328 Pins: identisch)
    - docs/schematic.pdf, README- und Journal-Abschnitt
    Claude-Session: https://claude.ai/code/session_0186hGEMKPCX4TUhcCqngWBe
    [heart.kicad_pcb, heart.kicad_sch]
2026-10-12 Gehäuse und Ständer als STEP (Fusion 360) und STL
    - cad/gen_case.py (CadQuery): Rückschale mit Abstandshaltern,
    USB-C-Schlitz, XIAO-Kabelfenster, Tasterloch und Schlüssellöchern;
    Pixel-Gitter im 16-mm-Raster; Diffusor; Tasterstößel; Ständer mit
    90°-V-Tasche (passt zur Herzspitze), 10° geneigt
    - Herzumriss aus echten Kreisbögen -> glatte Flächen, kleine STEP-Dateien
    - Kollisionsprüfung gegen Platine, XIAO, Elko, Taster und USB-Buchse
    - cad/out: STEP + STL aller Teile, Zusammenbau-STEP inkl. KiCad-Platine
    - Renderbilder in docs/, README-Abschnitt und Journal-Eintrag
    Claude-Session: https://claude.ai/code/session_0186hG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
    [heart_case_assembly.step, heart_case_button_plunger.step, heart_case_button_plunger.stl, heart_case_diffuser.step, heart_case_diffuser.stl, heart_case_grid.step, heart_case_grid.stl, heart_case_shell.step]
2026-10-12 JOURNAL.md für die Stardance-Migration umgebaut
    Jeder Eintrag hat Datum, Stunden und Bild (absolute raw-Links auf main),
    das ganze Projekt ist abgedeckt (Planung, Platine, Firmware, Schaltplan,
    Gehäuse). Hinweis auf die Mithilfe von Claude Code.
    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
2026-10-12 Gehäuseteile zusätzlich als 3MF exportieren
    - jedes Teil als .3mf (Millimeter, wasserdicht geprüft)
    - feinere Rundungen (Winkeltoleranz 0,05 rad statt 0,2)
    - Druckdateien (3MF/STL) liegen auf dem Druckbett, STEP bleibt in Einbauposition
    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
    [heart_case_assembly.step, heart_case_button_plunger.3mf, heart_case_button_plunger.step, heart_case_button_plunger.stl, heart_case_diffuser.3mf, heart_case_diffuser.step, heart_case_diffuser.stl, heart_case_grid.3mf]
2026-10-12 Kostenaufstellung mit Live-Preisen und Filamentbedarf
    - tools/kosten.py fragt LCSC-Preise und den USD/EUR-Kurs live ab,
    rechnet JLCPCB-Bestückung (Economic PCBA) und schreibt KOSTEN.md
    - Filamentverbrauch mit PrusaSlicer berechnet (cad/slicer_pla.ini):
    220 g Anycubic PLA+ -> 1 Rolle reicht
    - Leiterplatten- und Versandpreis als Schätzung markiert
    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
2026-10-12 Filamentbedarf mit Anycubic-Kobra-2-Neo-Profil berechnen
    - cad/slicer_kobra2neo.ini: offizielle Anycubic-Profile für den Kobra 2 Neo
    (Drucker, "0.20mm Standard", "Anycubic PLA") für PrusaSlicer übersetzt
    - neu geslict: 210 g, ca. 10 h Druckzeit, 1 Rolle reicht
    - KOSTEN.md mit Verbrauch und Druckzeit pro Teil
    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
2026-10-12 Einkaufsliste (links.md, price.md) und Journal mit Arbeitszeit
    - einkauf/links.md: Kauflinks für Deutschland (BerryBase, Amazon mit
    Versand durch Amazon, JLCPCB)
    - einkauf/price.md: alle Preise in Euro und Dollar; BerryBase-, LCSC- und
    Referenzpreise sowie Wechselkurs live abgefragt (tools/einkauf.py)
    - ersetzt KOSTEN.md / tools/kosten.py
    - JOURNAL.md: Zusammenarbeit mit Claude, was geprüft wurde, echte
    Arbeitszeit auf beide Tage verteilt (1,2 h + 1,3 h)
    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
2026-10-12 Echtes JLCPCB-Angebot (Leiterplatte 15,18 €, Versand 23,85 €) in price.md
    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
